usevolt/fsb/doc/ce_mark_fsb.pdf

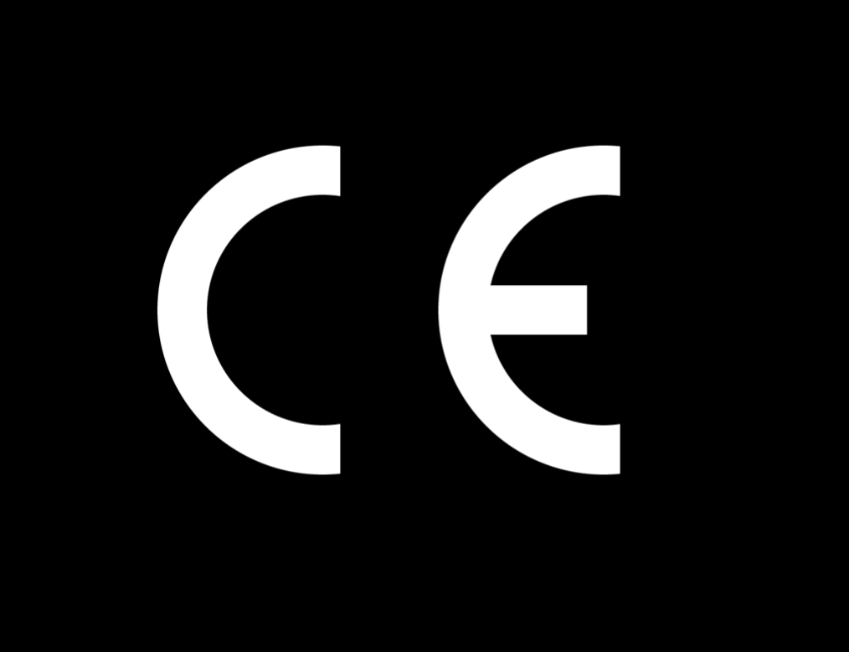
[picture p1: figure]

www.usewood.fi

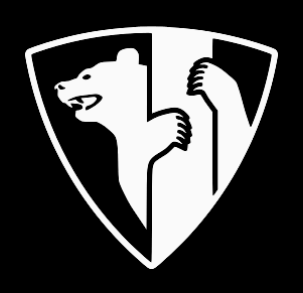
[picture p2: figure]

# Usewood FSB
