usevolt/fsb/doc/ce_mark_fsb_55x20mm.png

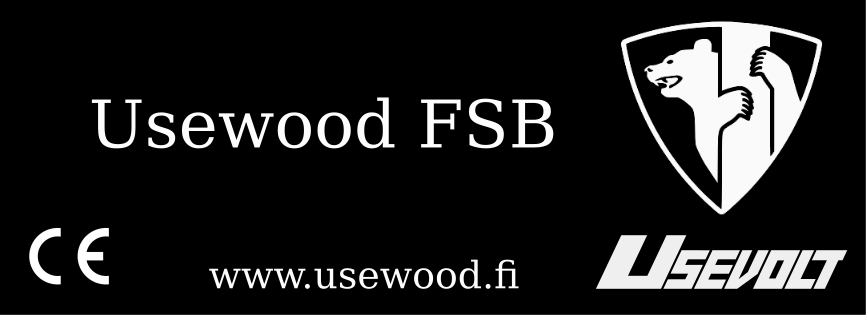
doc/ce_mark_fsb_55x20mm.png
