usevolt/fsb/hw/board_outline.dxf

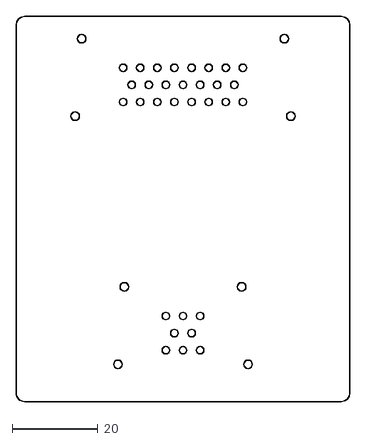
[picture p4: CAD file, 2018-10-11]
hw/board_outline.dxf
78.0 x 90.0
