usevolt/fsb/doc/Kubota V1505-T el wiring.pdf

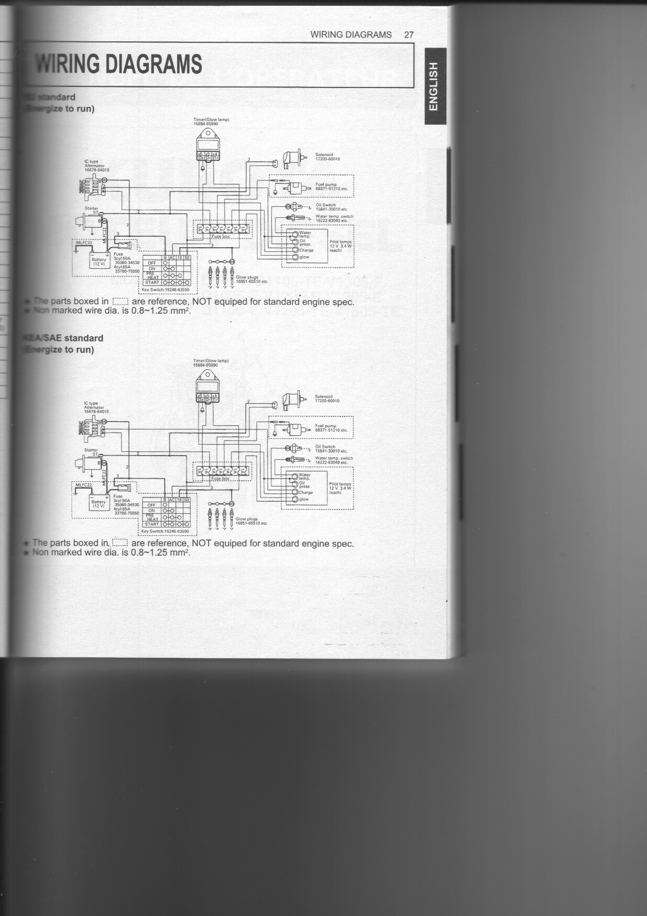
[picture p6: page 1]
