usevolt/fsb/(commit log)

2017-08-14 1.0.0 pcb ready to order
    [LT1161.sch, LT1161_2.sch, currentSense.sch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]
2017-09-05 analog shortcircuit protection to LT1161
    [LT1161.sch, _saved_LT1161_2.sch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]
2017-09-20 creating hw 3.0.0
    [LT1161.sch, LT1161_2.sch, _saved_LT1161_2.sch, currentSense.sch, currentSense2.sch, currentSense3.sch, fsb.kicad_pcb, fsb.sch]
2017-09-20 key_50 moved out from ISP pin
    [LT1161.sch, currentSense2.sch, currentSense3.sch, fsb.kicad_pcb, fsb.sch, lpc1549.sch, optocoupler.sch, pwr_supply_sheet.sch]
2017-10-24 radio & aux are on when ign key is on
    [LT1161.sch, currentSense2.sch, currentSense3.sch, fsb.kicad_pcb, fsb.sch, lpc1549.sch, optocoupler.sch, pwr_supply_sheet.sch]
2017-11-11 heater shuts down when ignition key is turned off
    [LT1161.sch, currentSense2.sch, currentSense3.sch, fsb.kicad_pcb, fsb.sch, lpc1549.sch, optocoupler.sch, pwr_supply_sheet.sch]
2017-11-16 hw 2.1.0 created, not yet ordered
    [fsb.kicad_pcb, fsb.sch, lpc1549.sch, pwr_supply_sheet.sch]
2017-11-18 2.1.0 gerbers created for seeed studios
    [fsb-B.Cu.gbl, fsb-B.Mask.gbs, fsb-B.SilkS.gbo, fsb-Edge.Cuts.gm1, fsb-F.Cu.gtl, fsb-F.Mask.gts, fsb-F.SilkS.gto, fsb.drl]
2017-12-14 sw updated to hw 2.1 revision
    [vn5e010ah.sch]
2017-12-17 making 2.2.0 pcb
    [fsb.kicad_pcb, fsb.sch, heater.sch, lpc1549.sch, optocoupler.sch, pwr_supply_sheet.sch, vnd5050.sch]
2017-12-19 hw 2.2 ordered from seeed
    [fsb-B.Cu.gbl, fsb-B.Mask.gbs, fsb-B.SilkS.gbo, fsb-Edge.Cuts.gm1, fsb-F.Cu.gtl, fsb-F.Mask.gts, fsb-F.SilkS.gto, fsb.drl]
2018-02-19 radio fuse changed to 750 mA one
    [fsb.kicad_pcb, fsb.sch]
2018-03-27 3.0.0 hw with low side heater mosfet
    [_saved_fsb.sch, fsb-2018-03-27-17-41-22.sch, fsb-2018-03-27-18-23-40.sch, fsb.kicad_pcb, fsb.sch, heater-2018-03-27-17-41-22.sch, heater-2018-03-27-18-23-40.sch, lpc1549-2018-03-27-17-41-22.sch]
2018-03-27 last modifications to 3.0.0
    [_saved_fsb.sch, fsb.sch]
2018-04-24 hw 3.1.0 created. Fuel level moved from esb to fsb
    [fsb-B.Cu.gbl, fsb-B.Mask.gbs, fsb-B.SilkS.gbo, fsb-Edge.Cuts.gm1, fsb-F.Cu.gtl, fsb-F.Mask.gts, fsb-F.SilkS.gto, fsb.drl]
2018-05-29 4.1.0 pcb ordered, with modified flyback diodes
    [fsb-B.Cu.gbl, fsb-B.Mask.gbs, fsb-B.SilkS.gbo, fsb-Edge.Cuts.gm1, fsb-F.Cu.gtl, fsb-F.Mask.gts, fsb-F.SilkS.gto, fsb.drl]
2018-07-07 pcb with heater push-pull control circuit
    [fsb-B.Cu.gbl, fsb-B.Mask.gbs, fsb-B.SilkS.gbo, fsb-Edge.Cuts.gm1, fsb-F.Cu.gtl, fsb-F.Mask.gts, fsb-F.SilkS.gto, fsb.drl]
2018-07-29 variable heater speed working
    [heater.sch]
2018-07-29 heater speed bug fix without testing
    [main.c, main.h]
2018-08-07 bug fixes when moving fuel level to fsb
    [main.c, main.h, messages.c]
2018-09-09 safety disable parameter added
    [fsb.kicad_pcb]
2018-10-11 bugfix: eber fan input has moving avg which prevents eber fan input from toggling
    [board_outline.dxf]
2018-11-13 added averaging to inputs since heater causes lots of emc
2018-11-30 HAL updated to latest uv bootloader, starting to draw 6.0.0 pcb
    [fsb.kicad_pcb, heater.sch, pwr_supply_sheet.sch, vn5e010ah.sch, vnd5050.sch]
2018-12-20 heater speed is on/off for now, because of too much emcg
    [main.h]
2019-01-30 hw 6.0.0 created, fits uw aluminium enclosure
    [fsb-B.Cu.gbl, fsb-B.Mask.gbs, fsb-B.SilkS.gbo, fsb-Edge.Cuts.gm1, fsb-F.Cu.gtl, fsb-F.Mask.gts, fsb-F.Paste.gtp, fsb-F.SilkS.gto]
2019-02-25 door switches both removed for now
2019-03-19 sw for pc 6.0.0, with 2 heater outputs
2019-03-22 eber as assembly setting
2019-03-22 safety peripherals added individually to assembly settings
2019-07-29 door switches enabled
2019-09-10 100919: emcy logic changed from averaging to ring buffer that has to be full, to improve emcy filtering
2019-10-03 radio current increased to 3A
2020-01-17 ui is tried to set OUTPUT_STATE_ON in case of failure with 2000 ms delay
    [main.c, main.h]
2020-07-07 delay added for door & seat switches
2020-08-13 coolvalve added to fsb
    [fsb-B.Cu.gbl, fsb-B.Mask.gbs, fsb-B.SilkS.gbo, fsb-Edge.Cuts.gm1, fsb-F.Cu.gtl, fsb-F.Mask.gts, fsb-F.Paste.gtp, fsb-F.SilkS.gto]
2020-10-28 fsb heater speed renewed with cold air
2020-10-28 coolair valve logic inverted
    [main.c]
